EyupBEY/Glass/README.md

# The Most Quality ESP32-S3 Board Ever Made
