EyupBEY/Glass/List of Receipts.xlsx

Price(TL) | Amount | Name | Value | Link | Subtotal: | 2194.02
37.06 | 1 | J1 | GSB1C41110SSHR | https://www.e-komponent.com/usb-type-c-2-0-receptacle-connector-gsb1c41110sshr
36.27 | 1 | J2 | TB002-500-02BE | https://www.e-komponent.com/2-position-wire-to-board-terminal-block-horizontal-with-board-22350
50.49 | 1 | J5 | 5051102491 | https://www.e-komponent.com/fpc-connector
31.83 | 1 | ANT1 | SR4W035 | https://www.e-komponent.com/24-ghz-wi-fi-bluetooth-anten-serica-smd
27.45 | 1 | U1 | USBLC6-2SC6 | USBLC6-2SC6 UMW - TVS Diyotlar - e-komponent (https://www.e-komponent.com/17v-clamp-5a-8-20s-ipp-tvs-diode-surface-mount-sot-23-34240)
74.4 | 1 | U2 + U3 + Q2 | TP4056 Module | https://robolinkmarket.com/tp4056-type-c-korumali-sarj-modulu
40.68 | 1 | U4 | LDL1117S33R | https://www.e-komponent.com/linear-voltage-regulator-ic-33v-1-output-12a-sot-223
235.41 | 1 | U5 | ESP32-S3R8 | https://tr.aliexpress.com/item/1005003691510275.html
91.18 | 1 | U7 | W25Q128JVSIQ | https://tr.aliexpress.com/item/1005005997333641.html?gatewayAdapt=glo2tur
136.78 | 1 | U8 | RT9193-12GB | https://tr.aliexpress.com/item/1005006177716976.html
7.28 | 1 | U9 | RT9193-28GB | https://tr.aliexpress.com/item/1005006177716976.html
394.85 | 1 | U6 | LY68L6400 | https://tr.aliexpress.com/i/1005003978604678.html
27.72 | 2 | RESET, PROGRAM | 434121043816 | https://www.e-komponent.com/tactile-switch-434121043816
25.49 | 1 | SW1 | 1825232-1 | https://www.e-komponent.com/slide-switch-spdt-through-hole-right-angle-19828
124.5 | 1 | K1 (MicroSD Card Holder) | 112J-TDAR-R01 | https://www.e-komponent.com/micro-sdsocket-push-push-type
13.72 | 1 | Q1 | AO3421E | https://www.e-komponent.com/p-channel-30v-3a-ta-14w-ta-surface-mount-sot-23-3
211.88 | 1 | D1, D2 | PMEG6030EVPX | https://tr.aliexpress.com/item/1005004051915626.html
21.08 | 1 | Y1 | ECS-400-10-37B2-CKM-TR | https://www.e-komponent.com/40-mhz-10ppm-crystal
47.44 | 1 | Y2 | ECS-.327-6-34QCS-TR | https://www.e-komponent.com/crystal-6pf-24024
4.9 | 3 | L1, L3 | LQG15HN2N0C02D | https://www.e-komponent.com/2-nh-unshielded-multilayer-inductor
7.35 | 2 | L2 | LQW18AN24NG00D | https://www.e-komponent.com/24-nh-unshielded-wirewound-inductor-23755
2.35 | 10 | R1, R2, R18, R19 | 5.1K(0603) | https://www.e-komponent.com/chip-resistor-pulse-withstanding-thick-film-14642
0.64 | 50 | R14, R20, R21, R22, R23, R25, R26, R29, R27, R28 | 10K(0603) | https://www.e-komponent.com/chip-resistor-moisture-resistant-thick-film-17999
13.72 | 2 | R3 | TC33X-2-103E | https://www.e-komponent.com/j-lead-surface-mount-trimmer-potentiometer-cermet
0.74 | 10 | R4, R15, R16 | 100K(0603) | https://www.e-komponent.com/chip-resistor-thick-film-17297
0.74 | 10 | R5 | 1K(0603) | https://www.e-komponent.com/chip-resistor-thick-film-14993
1.03 | 10 | R6 | 100(0603) | https://www.e-komponent.com/chip-resistor-moisture-resistant-thick-film-17993
0.75 | 25 | R7, R9, R10, R11, R12, R13, R17, R24 | 0(0603) | https://www.e-komponent.com/chip-resistor-moisture-resistant-thick-film-14334
0.93 | 10 | R8 | 499(0603) | https://www.e-komponent.com/chip-resistor-moisture-resistant-thick-film-12583
4.7 | 5 | C3, C31 | 10μF (Electrolytic) | https://www.e-komponent.com/aluminum-electrolytic-capacitors-24491
9.07 | 10 | C11 | 10μF | https://www.e-komponent.com/ceramic-capacitors-14163
1.72 | 50 | C5, C7, C10, C19, C21, C22, C24, C25 | 1μF | https://www.e-komponent.com/1-uf-ceramic-capacitor-cl21b105kafnnng
2.01 | 50 | C1, C2, C6, C8, C9, C12, C13, C26, C27, C30, C32 | 0.1μF | https://www.e-komponent.com/ceramic-capacitors-15476
1.52 | 10 | C20, C23 | 22nF | https://www.e-komponent.com/ceramic-capacitors-16412
4.9 | 3 | C4 | 0.01μF --> 0.012μF | https://www.e-komponent.com/ceramic-capacitors-21433
1.64 | 10 | C14, C15, C16, C17 | 16pF | https://www.e-komponent.com/ceramic-capacitor-31485
1.83 | 10 | C18 | 1.5pF | https://www.e-komponent.com/15-pf-ceramic-capacitor-gjm1555c1h1r5cb01d
0 | 1 | J3, J4, J6, J7, J8 | Standard Connectors
 |  | İsimlendirme sıralamasını şöyle yap: R11 ile R23 arası 10uF dir diye.
 |  | Bazı parçaları fazlaca yazdım ki yedek de olsun, bazıları tam gereken kadar onları arttır.
