EyupBEY/Glass/Schematic.pdf

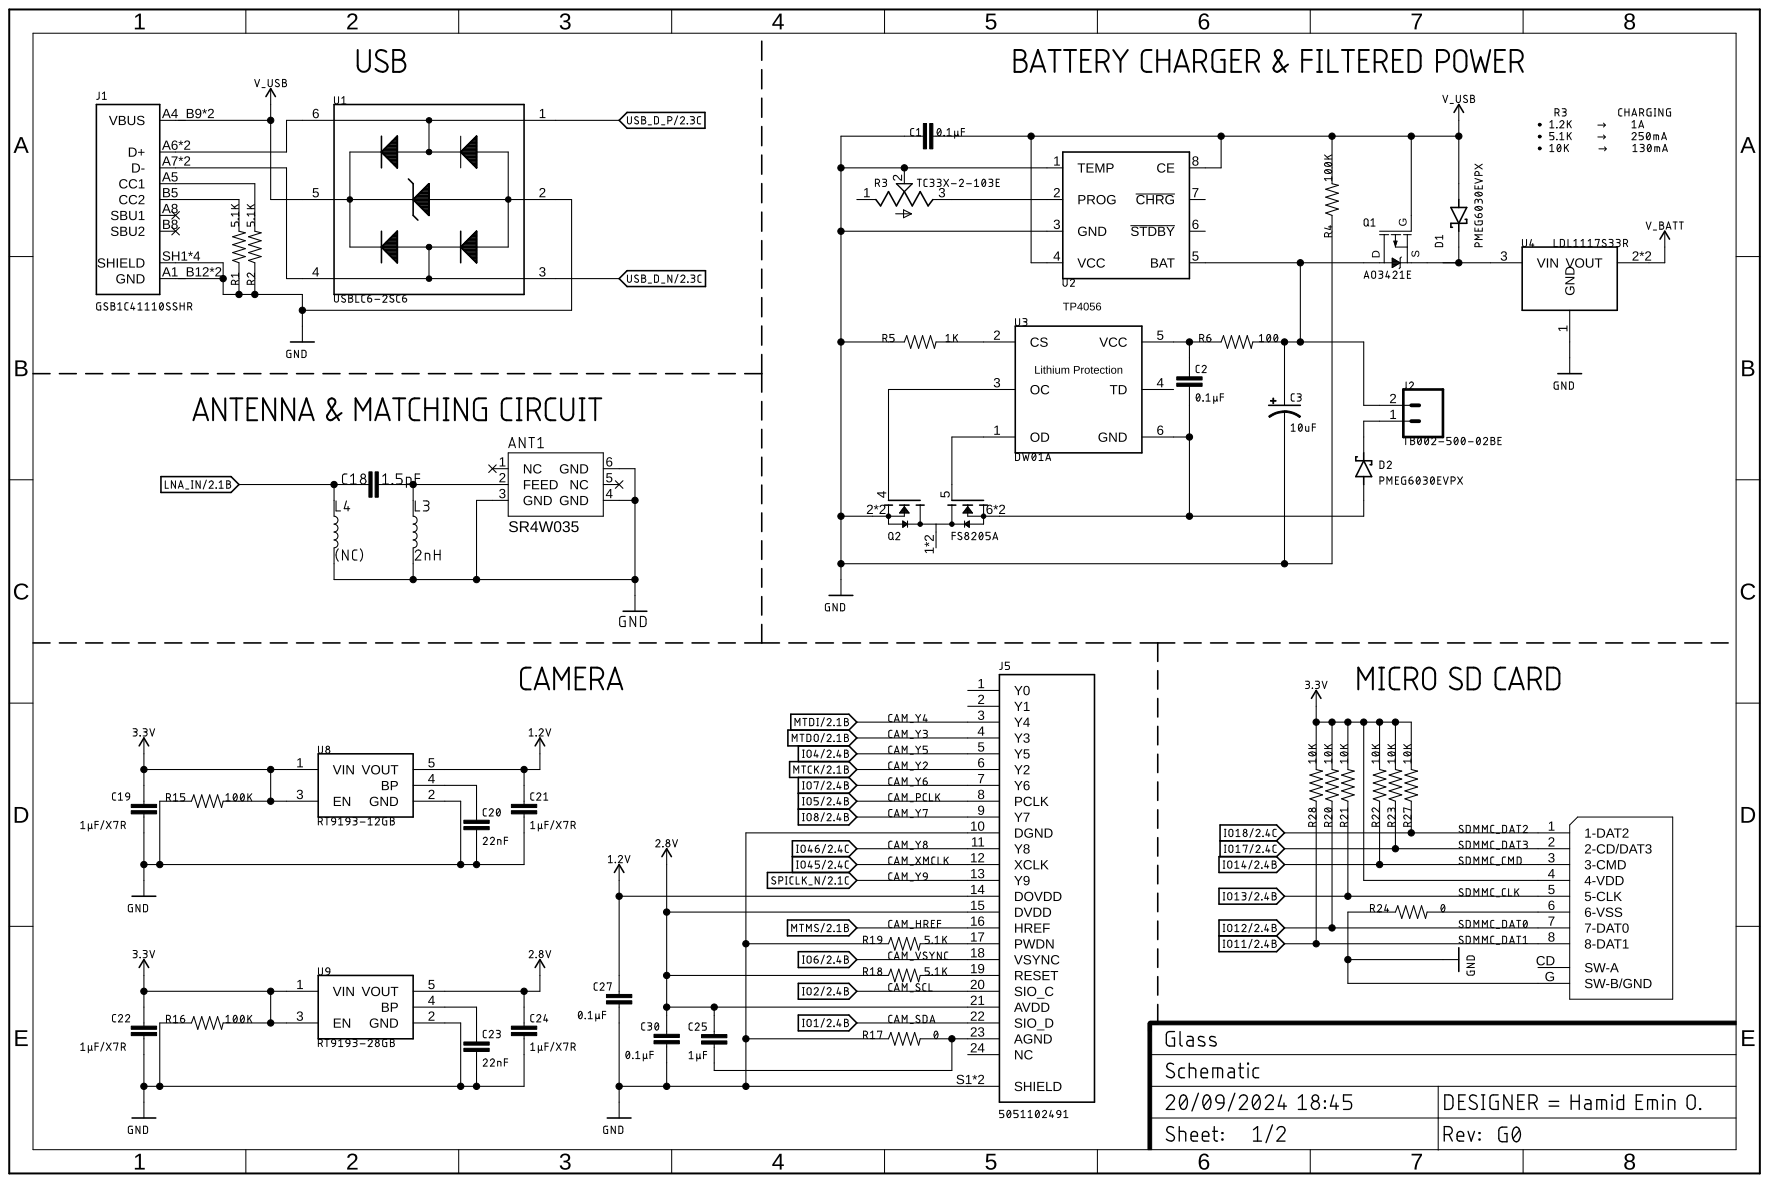
[picture p24: page 1]

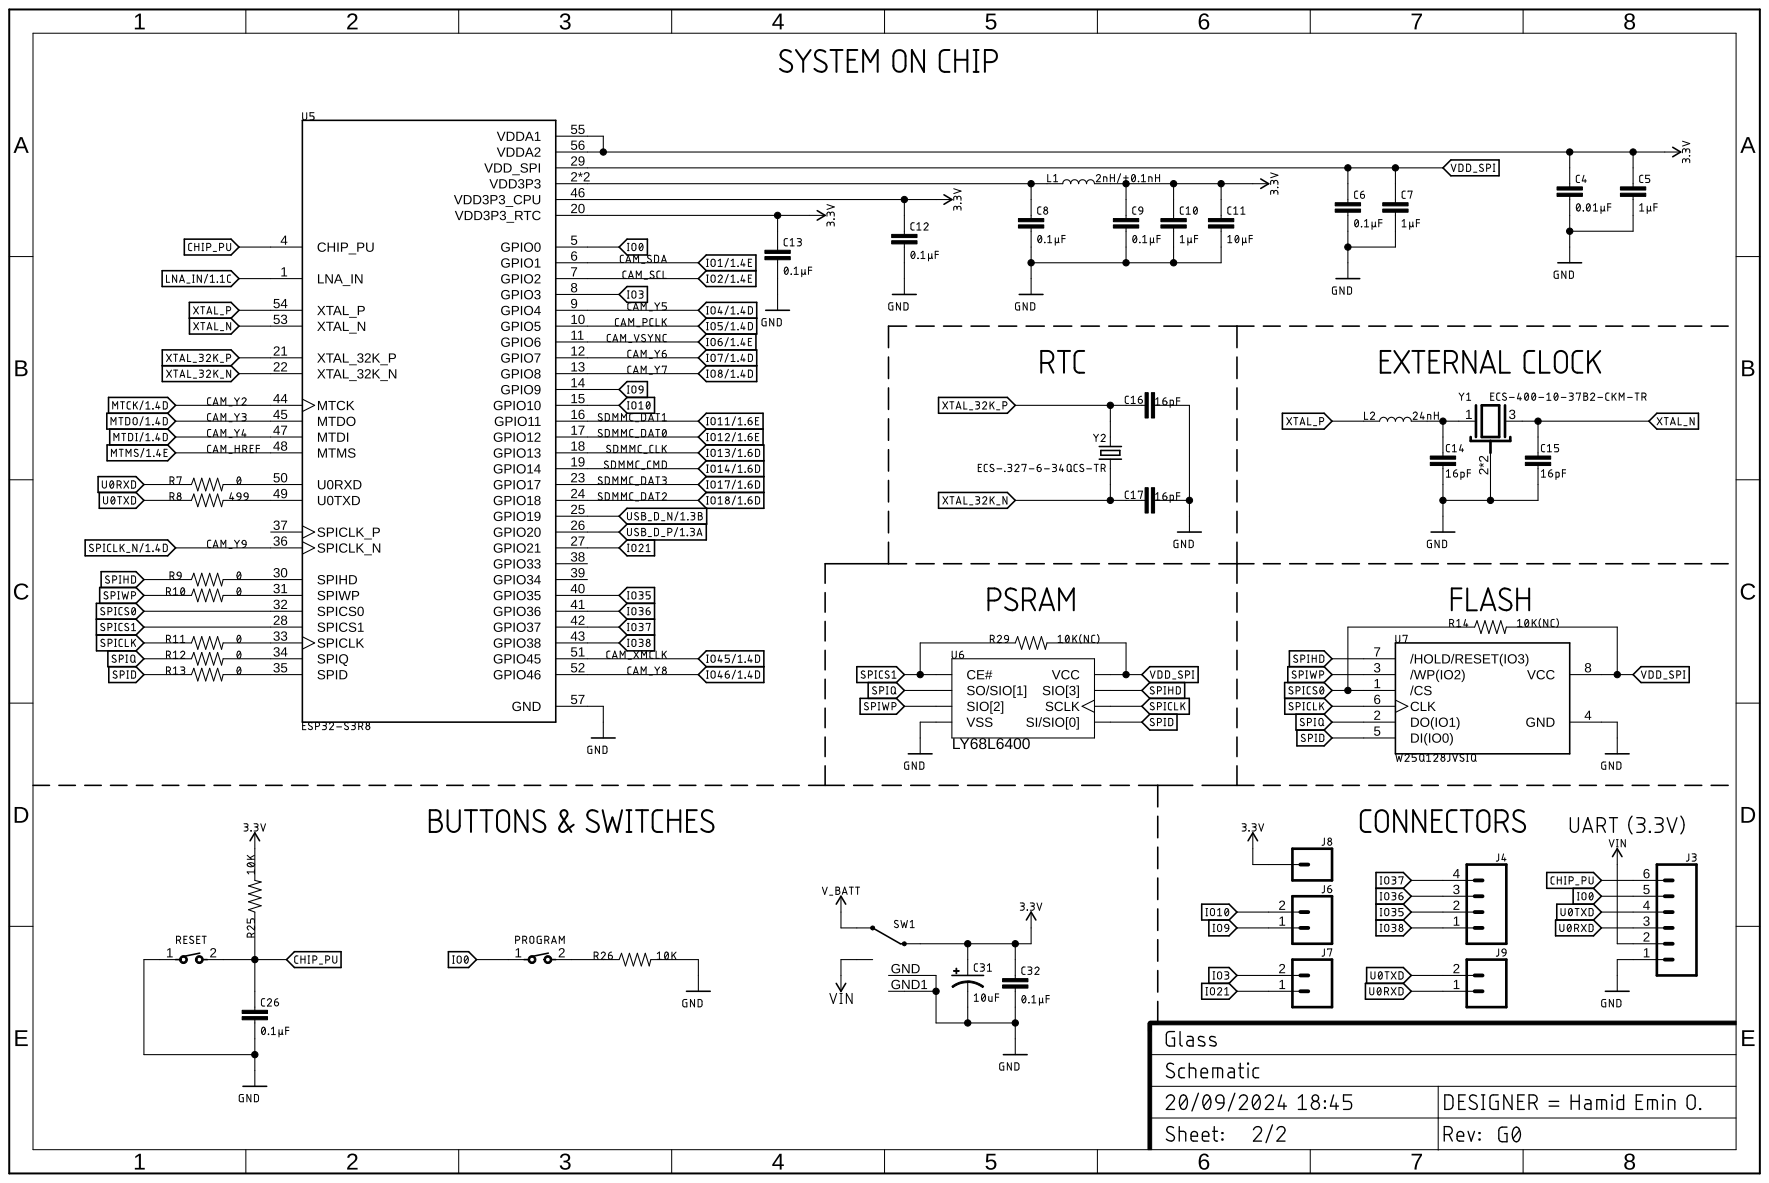
[picture p25: page 2]
