EyupBEY/Glass/Schematic.brd

## EAGLE design Schematic.brd (2024-09-20)

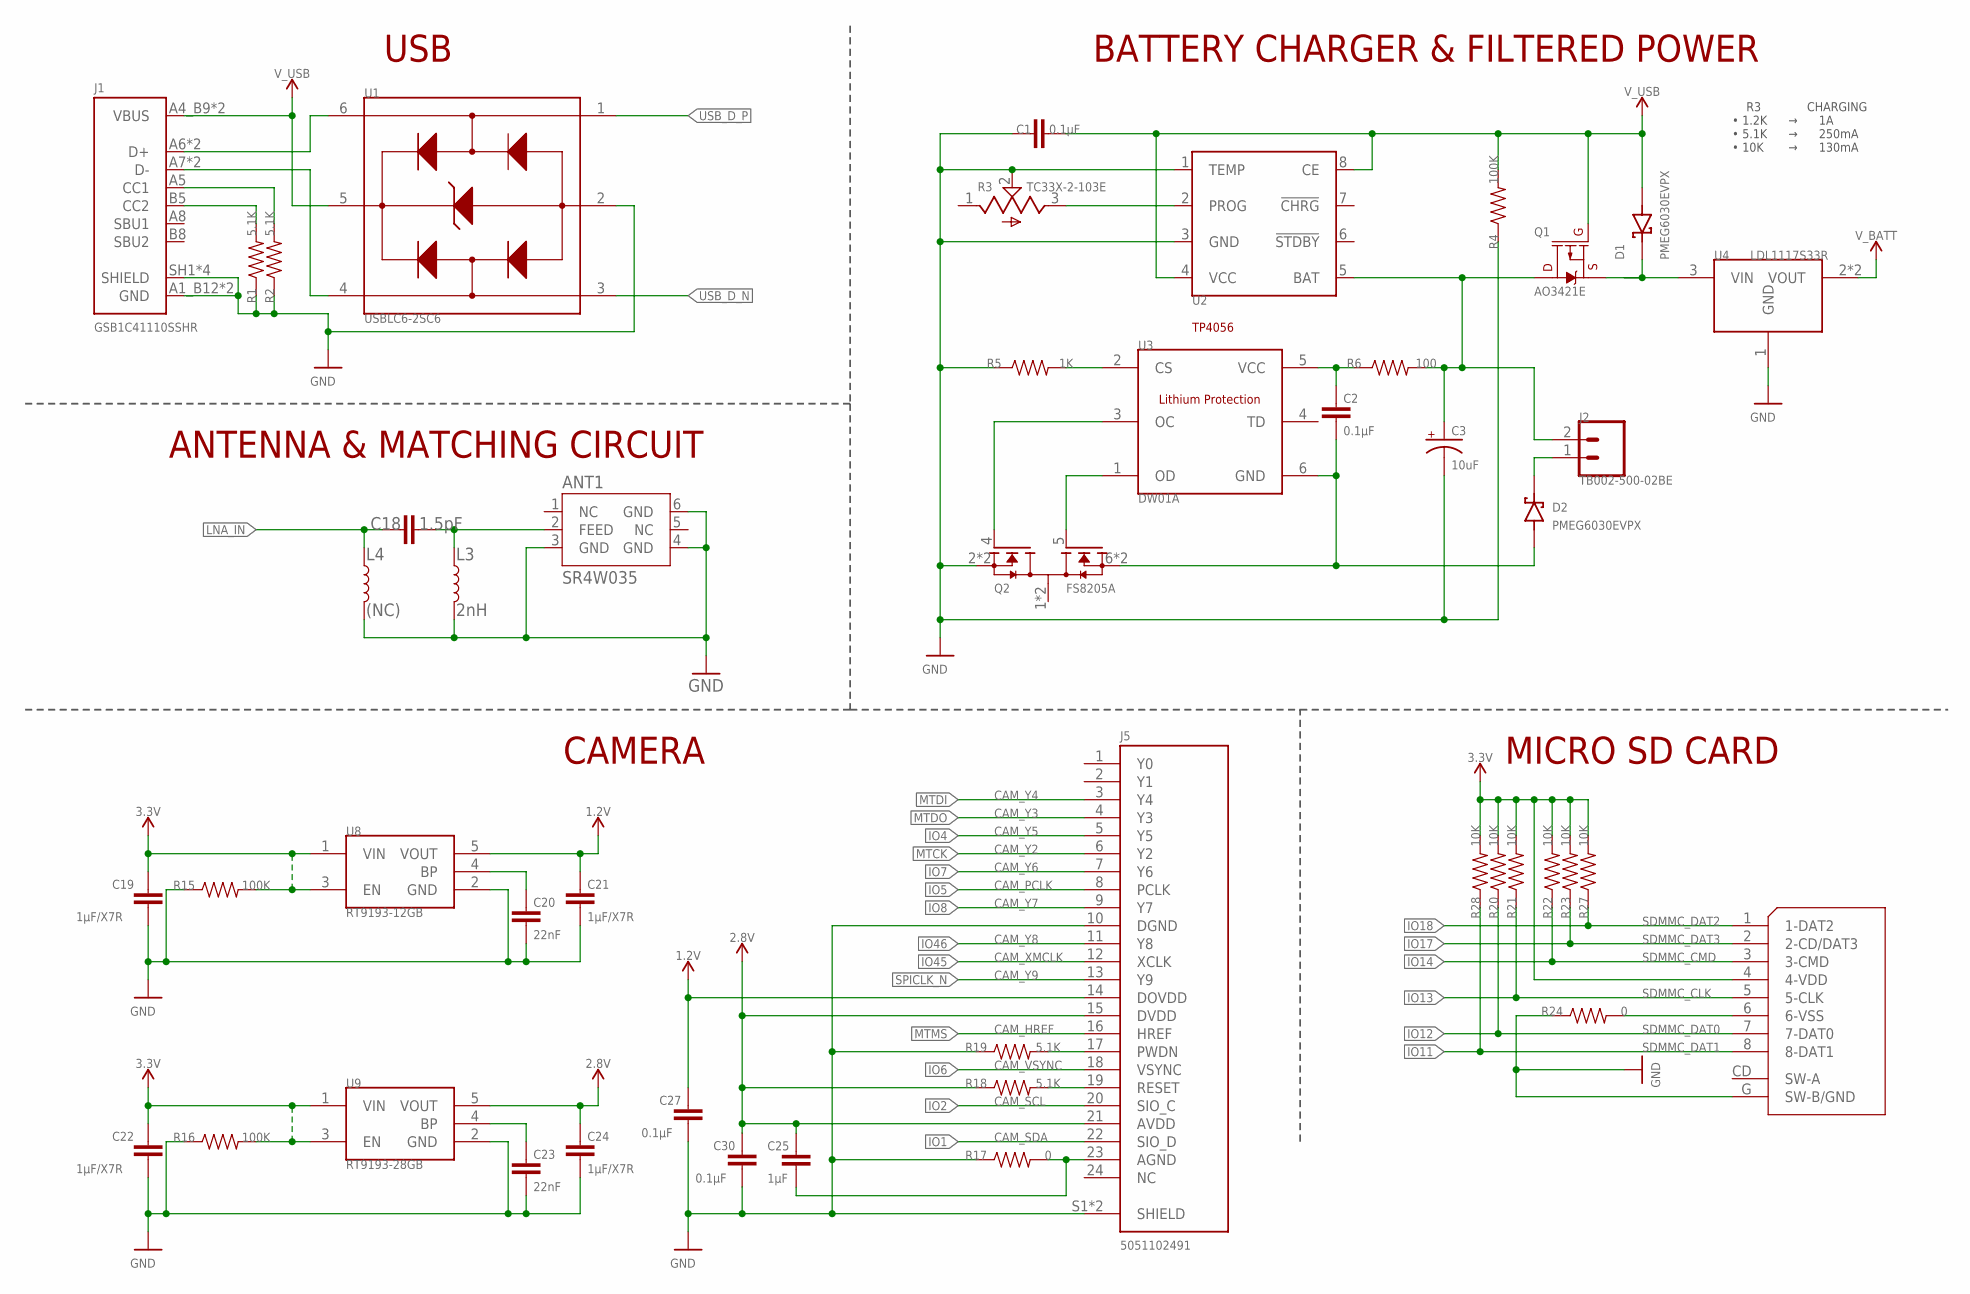
[picture p26: schematic Schematic.sch, sheet 1]

Parts:
ANT1: SR4W035
C1, C2, C27, C30: 0.1μF; 0805
C3: 10uF; CPOL-RADIAL-2.5MM-5MM
C18: 1.5pF; 0402
C19, C21, C22, C24: 1μF/X7R; 0805
C20, C23: 22nF; 0603
C25: 1μF; 0805
D1, D2: PMEG6030EVPX; DIO_PMEG6030EVPX
J1: GSB1C41110SSHR; AMPHENOL_GSB1C41110SSHR
J2: TB002-500-02BE; SCREWTERMINAL-5MM-2
J5: 5051102491; MOLEX_5051102491
K1: 112J-TDAR-R01
L3: 2nH; 0402
L4: (NC); 0402
Q1: AO3421E; SOT23-3
Q2: FS8205A; SOP65P640X120-8N
R1, R2, R18, R19: 5.1K; 0603
R3: TC33X-2-103E; TRIM_TC33X-2-103E
R4, R15, R16: 100K; 0603
R5: 1K; 0603
R6: 100; 0603
R17, R24: 0; 0603
R20, R21, R22, R23, R27, R28: 10K; 0603
U1: USBLC6-2SC6; SOT95P280X145-6N
U2: TP4056; SOT23-8
U3: DW01A; SOT23-6
U4: LDL1117S33R; SOT230P700X180-4N
U8: RT9193-12GB; SOT94P279X129-5N
U9: RT9193-28GB; SOT94P279X129-5N

Connections:
1.1V: C21.2, C27.2, J5.14 (DOVDD), U8.5 (VOUT)
2.8V: C24.2, C25.2, C30.2, J5.15 (DVDD), J5.21 (AVDD), R18.1, U9.5 (VOUT)
3.3V: C19.2, C22.2, K1.4 (4-VDD), R15.2, R16.2, R20.2, R21.2, R22.2, R23.2, R27.2, R28.2, U8.1 (VIN), U8.3 (EN), U9.1 (VIN), U9.3 (EN); also elsewhere on the board
GND: ANT1.3 (GND), ANT1.4 (GND), ANT1.6 (GND), C1.1, C3.2 (-), C19.1, C20.1, C21.1, C22.1, C23.1, C24.1, C27.1, C30.1, J1.A1_B12 (GND), J1.B1_A12 (GND), J1.SH1 (SHIELD), J1.SH2 (SHIELD), J1.SH3 (SHIELD), J1.SH4 (SHIELD), J5.10 (DGND), J5.S1 (SHIELD), J5.S2 (SHIELD), K1.G (SW-B/GND), L3.2, L4.2, Q2.2 (S1), Q2.3 (S1), R1.1, R2.1, R3.2 (W), R4.1, R5.1, R15.1, R16.1, R17.1, R19.1, R24.1, U1.2 (GND), U2.1 (TEMP), U2.3 (GND), U4.1 (GND), U8.2 (GND), U9.2 (GND); also elsewhere on the board
IO1: J5.22 (SIO_D); also elsewhere on the board
IO2: J5.20 (SIO_C); also elsewhere on the board
IO4: J5.5 (Y5); also elsewhere on the board
IO5: J5.8 (PCLK); also elsewhere on the board
IO6: J5.18 (VSYNC); also elsewhere on the board
IO7: J5.7 (Y6); also elsewhere on the board
IO8: J5.9 (Y7); also elsewhere on the board
IO11: K1.8 (8-DAT1), R28.1; also elsewhere on the board
IO12: K1.7 (7-DAT0), R20.1; also elsewhere on the board
IO13: K1.5 (5-CLK), R21.1; also elsewhere on the board
IO14: K1.3 (3-CMD), R22.1; also elsewhere on the board
IO17: K1.2 (2-CD/DAT3), R23.1; also elsewhere on the board
IO18: K1.1 (1-DAT2), R27.1; also elsewhere on the board
IO45: J5.12 (XCLK); also elsewhere on the board
IO46: J5.11 (Y8); also elsewhere on the board
LNA_IN: C18.1, L4.1; also elsewhere on the board
MTCK: J5.6 (Y2); also elsewhere on the board
MTDI: J5.3 (Y4); also elsewhere on the board
MTDO: J5.4 (Y3); also elsewhere on the board
MTMS: J5.16 (HREF); also elsewhere on the board
unnamed: J1.A7 (D-), J1.B7 (D-), U1.4 (I/O2_OUT)
unnamed: Q2.5 (G2), U3.1 (OD)
unnamed: Q2.4 (G1), U3.3 (OC)
unnamed: J1.A5 (CC1), R2.2
unnamed: R5.2, U3.2 (CS)
unnamed: J1.B5 (CC2), R1.2
unnamed: K1.6 (6-VSS), R24.2
unnamed: R3.3 (CW), U2.2 (PROG)
unnamed: D2.1 (K), J2.1
unnamed: C2.2, R6.1, U3.5 (VCC)
unnamed: ANT1.2 (FEED), C18.2, L3.1
unnamed: J1.A6 (D+), J1.B6 (D+), U1.6 (I/O1_OUT)
unnamed: C2.1, D2.2 (A), Q2.6 (S2), Q2.7 (S2), U3.6 (GND)
unnamed: C20.2, U8.4 (BP)
unnamed: C23.2, U9.4 (BP)
unnamed: J5.19 (RESET), R18.2
unnamed: C3.1 (+), J2.2, Q1.3 (D), R6.2, U2.5 (BAT)
unnamed: D1.1 (K), Q1.2 (S), U4.3 (VIN)
unnamed: J5.17 (PWDN), R19.2
unnamed: C25.1, J5.23 (AGND), R17.2
SPICLK_N: J5.13 (Y9); also elsewhere on the board
USB_D_N: U1.3 (I/O2_IN); also elsewhere on the board
USB_D_P: U1.1 (I/O1_IN); also elsewhere on the board
V_BATT: U4.2 (VOUT), U4.4 (VOUT); also elsewhere on the board
V_USB: C1.2, D1.2 (A), J1.A4_B9 (VBUS), J1.B4_A9 (VBUS), Q1.1 (G), R4.2, U1.5 (VBUS), U2.4 (VCC), U2.8 (CE)

Notes on the sheet:
R3 CHARGING • 1.2K → 1A • 5.1K → 250mA • 10K → 130mA
USB
BATTERY CHARGER & FILTERED POWER
ANTENNA & MATCHING CIRCUIT
MICRO SD CARD
CAMERA
CAM_Y2
CAM_Y3
CAM_Y4
CAM_HREF
CAM_Y9
CAM_Y8
CAM_XMCLK
CAM_Y7
CAM_Y6
CAM_VSYNC
CAM_PCLK
CAM_Y5
CAM_SCL
CAM_SDA

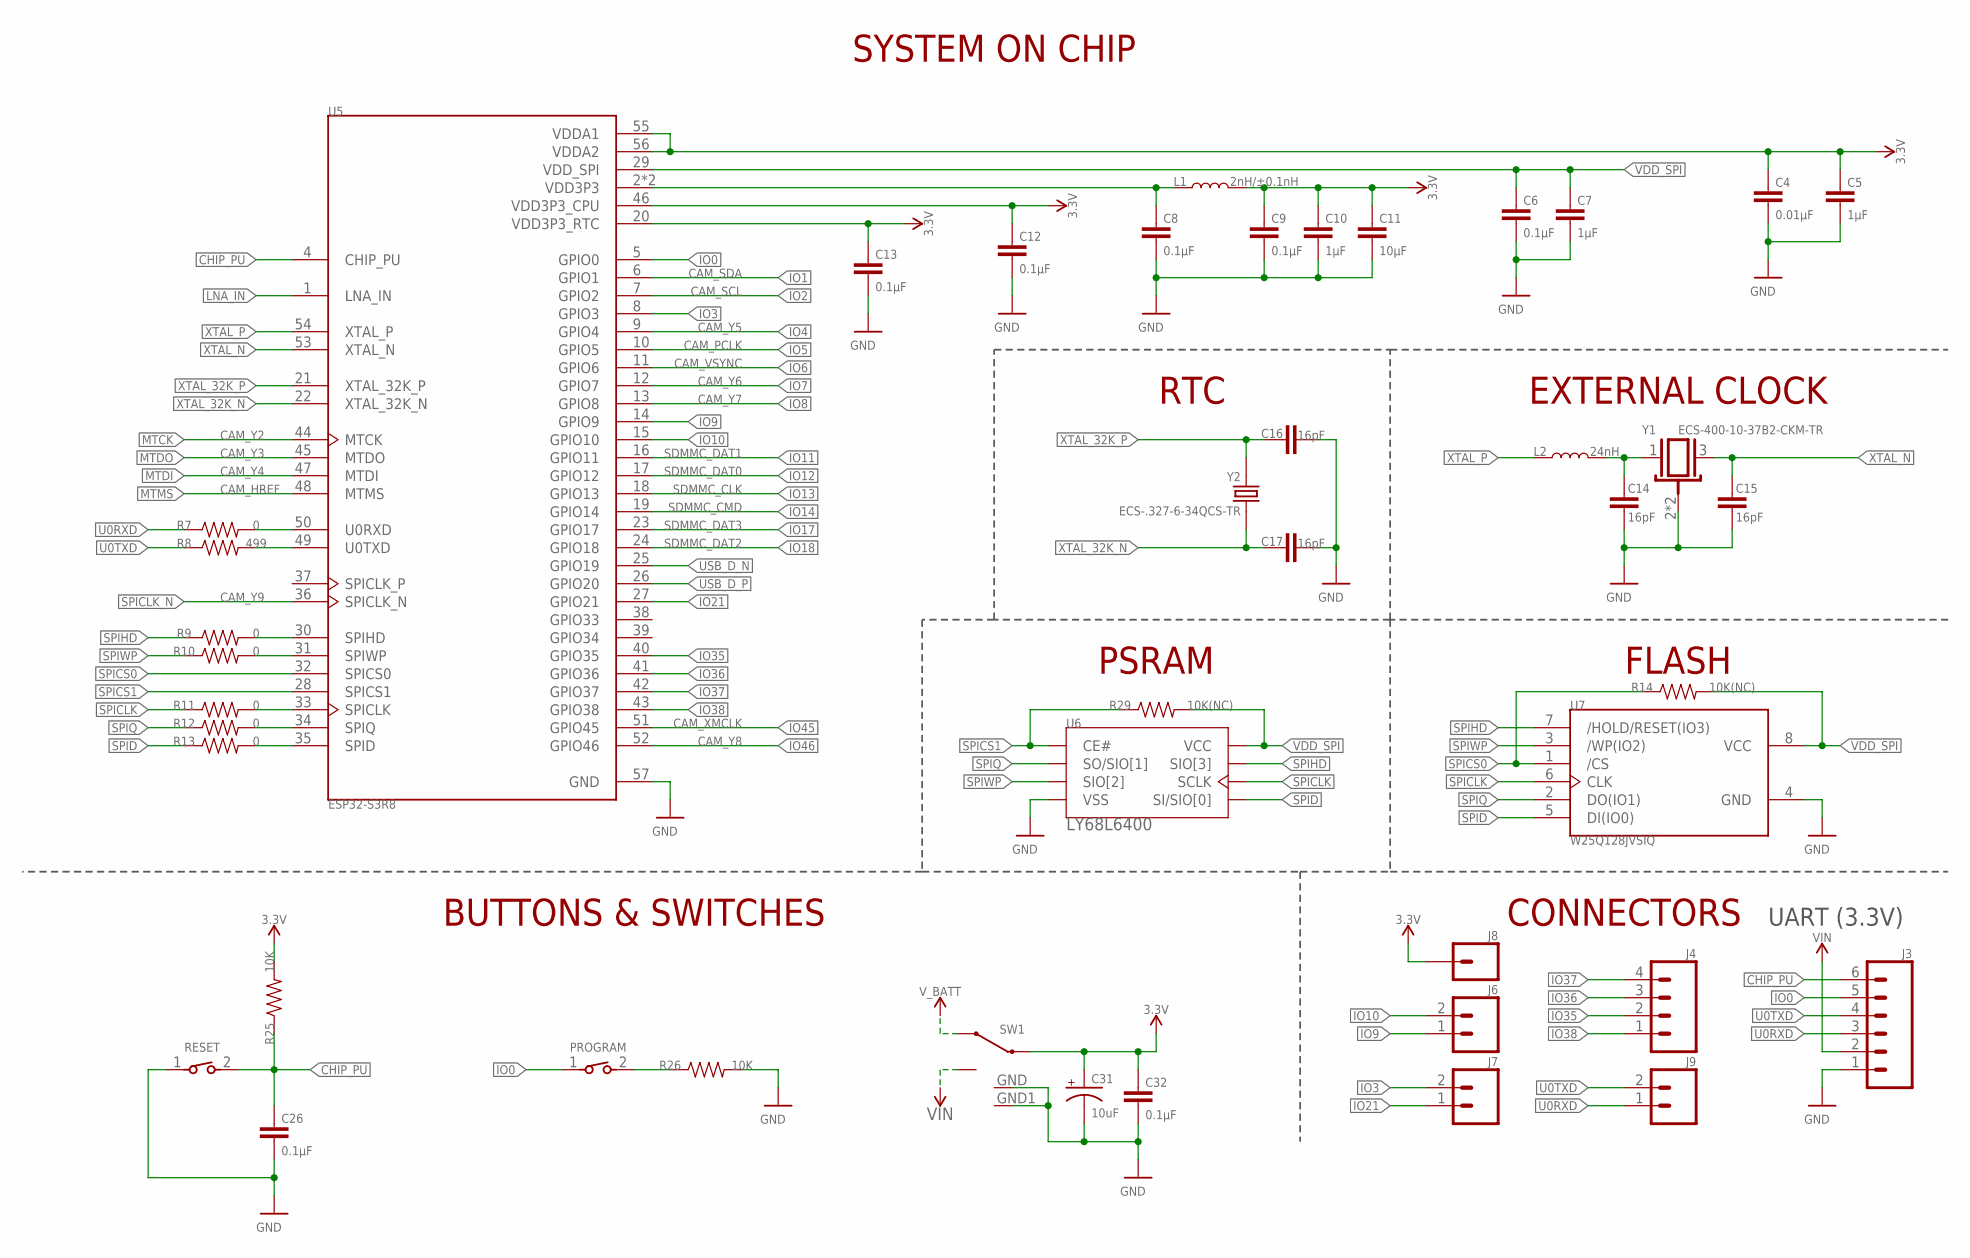
[picture p27: schematic Schematic.sch, sheet 2]

Parts:
C4: 0.01μF; 0603
C5, C7, C10: 1μF; 0805
C6, C8, C9, C12, C13, C26, C32: 0.1μF; 0805
C11: 10μF; 0805
C14, C15, C16, C17: 16pF; 0402
C31: 10uF; CPOL-RADIAL-2.5MM-5MM
J3: CONN_06SILK_FEMALE_PTH; 1X06
J4: CONN_04PTH; 1X04
J6, J7, J9: CONN_02; 1X02
J8: CONN_01; 1X01
L1: 2nH/±0.1nH; 0402
L2: 24nH; 0603
PROGRAM: 434121043816
R7, R9, R10, R11, R12, R13: 0; 0603
R8: 499; 0603
R14, R29: 10K(NC); 0603
R25, R26: 10K; 0603
RESET: 434121043816
SW1: 1825232-1
U5: ESP32-S3R8; IC_ESP32-S3
U6: LY68L6400; SOP
U7: W25Q128JVSIQ; SOIC127P790X216-8N
Y1: ECS-400-10-37B2-CKM-TR; XTAL_ECS-400-10-37B2-CKM-TR
Y2: ECS-.327-6-34QCS-TR; XTAL_ECS-.327-6-34QCS-TR

Connections:
3.3V: C4.2, C5.2, C9.2, C10.2, C11.2, C12.2, C13.2, C31.1 (+), C32.2, J8.1, L1.2, R25.2, SW1.2, U5.20 (VDD3P3_RTC), U5.46 (VDD3P3_CPU), U5.55 (VDDA1), U5.56 (VDDA2); also elsewhere on the board
CHIP_PU: C26.2, J3.6, R25.1, RESET.2, U5.4 (CHIP_PU)
GND: C4.1, C5.1, C6.1, C7.1, C8.1, C9.1, C10.1, C11.1, C12.1, C13.1, C14.1, C15.1, C16.2, C17.2, C26.1, C31.2 (-), C32.1, J3.1, R26.2, RESET.1, SW1.GND, SW1.GND1, U5.57 (GND), U6.VSS, U7.4 (GND), Y1.2 (GND), Y1.4 (GND); also elsewhere on the board
IO0: J3.5, PROGRAM.1, U5.5 (GPIO0)
IO1: U5.6 (GPIO1); also elsewhere on the board
IO2: U5.7 (GPIO2); also elsewhere on the board
IO3: J7.2, U5.8 (GPIO3)
IO4: U5.9 (GPIO4); also elsewhere on the board
IO5: U5.10 (GPIO5); also elsewhere on the board
IO6: U5.11 (GPIO6); also elsewhere on the board
IO7: U5.12 (GPIO7); also elsewhere on the board
IO8: U5.13 (GPIO8); also elsewhere on the board
IO9: J6.1, U5.14 (GPIO9)
IO10: J6.2, U5.15 (GPIO10)
IO11: U5.16 (GPIO11); also elsewhere on the board
IO12: U5.17 (GPIO12); also elsewhere on the board
IO13: U5.18 (GPIO13); also elsewhere on the board
IO14: U5.19 (GPIO14); also elsewhere on the board
IO17: U5.23 (GPIO17); also elsewhere on the board
IO18: U5.24 (GPIO18); also elsewhere on the board
IO21: J7.1, U5.27 (GPIO21)
IO35: J4.2, U5.40 (GPIO35)
IO36: J4.3, U5.41 (GPIO36)
IO37: J4.4, U5.42 (GPIO37)
IO38: J4.1, U5.43 (GPIO38)
IO45: U5.51 (GPIO45); also elsewhere on the board
IO46: U5.52 (GPIO46); also elsewhere on the board
LNA_IN: U5.1 (LNA_IN); also elsewhere on the board
MTCK: U5.44 (MTCK); also elsewhere on the board
MTDI: U5.47 (MTDI); also elsewhere on the board
MTDO: U5.45 (MTDO); also elsewhere on the board
MTMS: U5.48 (MTMS); also elsewhere on the board
unnamed: C8.2, L1.1, U5.2 (VDD3P3), U5.3 (VDD3P3)
unnamed: C14.2, L2.2, Y1.1
unnamed: PROGRAM.2, R26.1
unnamed: R7.2, U5.50 (U0RXD)
unnamed: R8.2, U5.49 (U0TXD)
unnamed: R9.2, U5.30 (SPIHD)
unnamed: R10.2, U5.31 (SPIWP)
unnamed: R11.2, U5.33 (SPICLK)
unnamed: R12.2, U5.34 (SPIQ)
unnamed: R13.2, U5.35 (SPID)
SPICLK: R11.1, U6.SCLK, U7.6 (CLK)
SPICLK_N: U5.36 (SPICLK_N); also elsewhere on the board
SPICS0: R14.1, U5.32 (SPICS0), U7.1 (/CS)
SPICS1: R29.1, U5.28 (SPICS1), U6.CE#
SPID: R13.1, U6.SI/SIO[0], U7.5 (DI(IO0))
SPIHD: R9.1, U6.SIO[3], U7.7 (/HOLD/RESET(IO3))
SPIQ: R12.1, U6.SO/SIO[1], U7.2 (DO(IO1))
SPIWP: R10.1, U6.SIO[2], U7.3 (/WP(IO2))
U0RXD: J3.3, J9.1, R7.1
U0TXD: J3.4, J9.2, R8.1
USB_D_N: U5.25 (GPIO19); also elsewhere on the board
USB_D_P: U5.26 (GPIO20); also elsewhere on the board
VDD_SPI: C6.2, C7.2, R14.2, R29.2, U5.29 (VDD_SPI), U6.VCC, U7.8 (VCC)
VIN: J3.2, SW1.1
V_BATT: SW1.3; also elsewhere on the board
XTAL_32K_N: C17.1, U5.22 (XTAL_32K_N), Y2.1 (I/O)
XTAL_32K_P: C16.1, U5.21 (XTAL_32K_P), Y2.2 (O/I)
XTAL_N: C15.2, U5.53 (XTAL_N), Y1.3
XTAL_P: L2.1, U5.54 (XTAL_P)

Notes on the sheet:
SYSTEM ON CHIP
EXTERNAL CLOCK
RTC
FLASH
BUTTONS & SWITCHES
CONNECTORS
UART (3.3V)
PSRAM

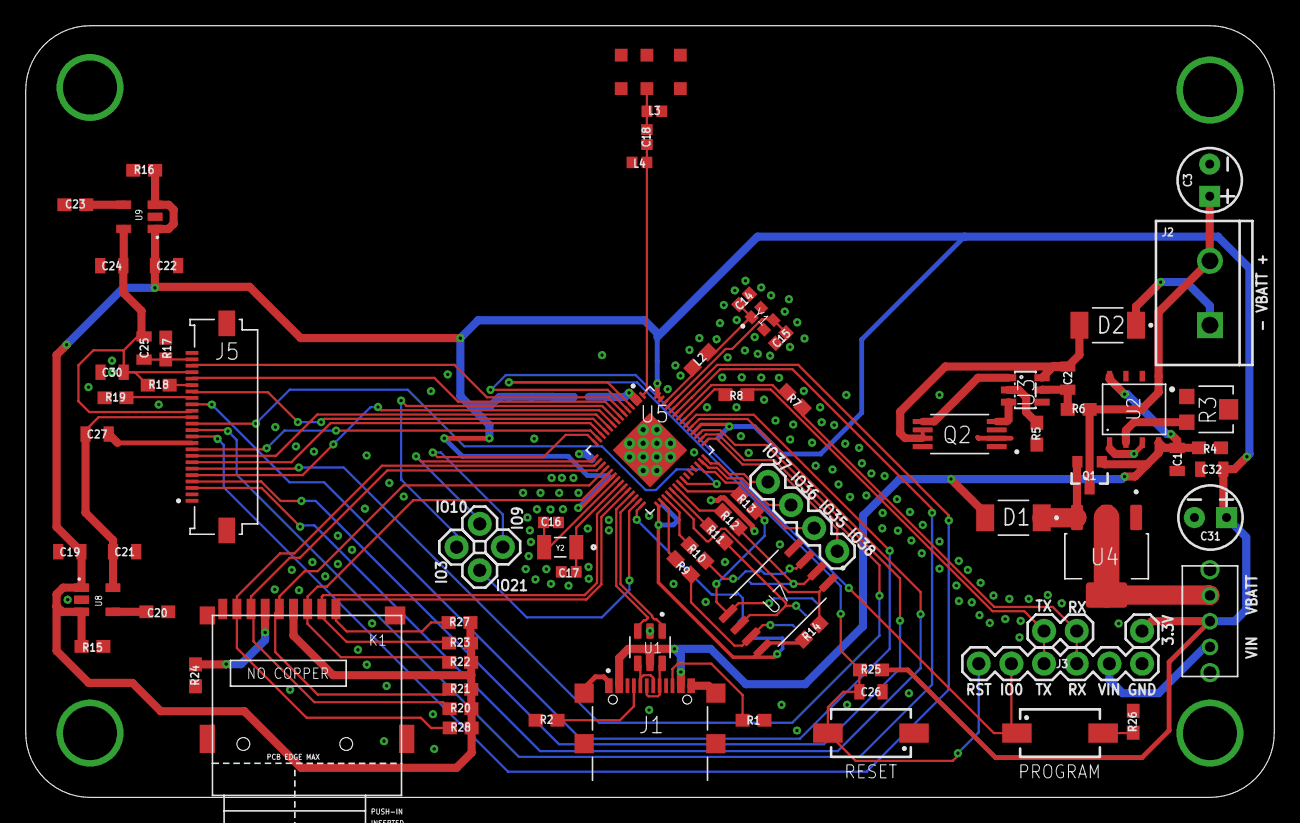
[picture p28: board Schematic.brd from above]

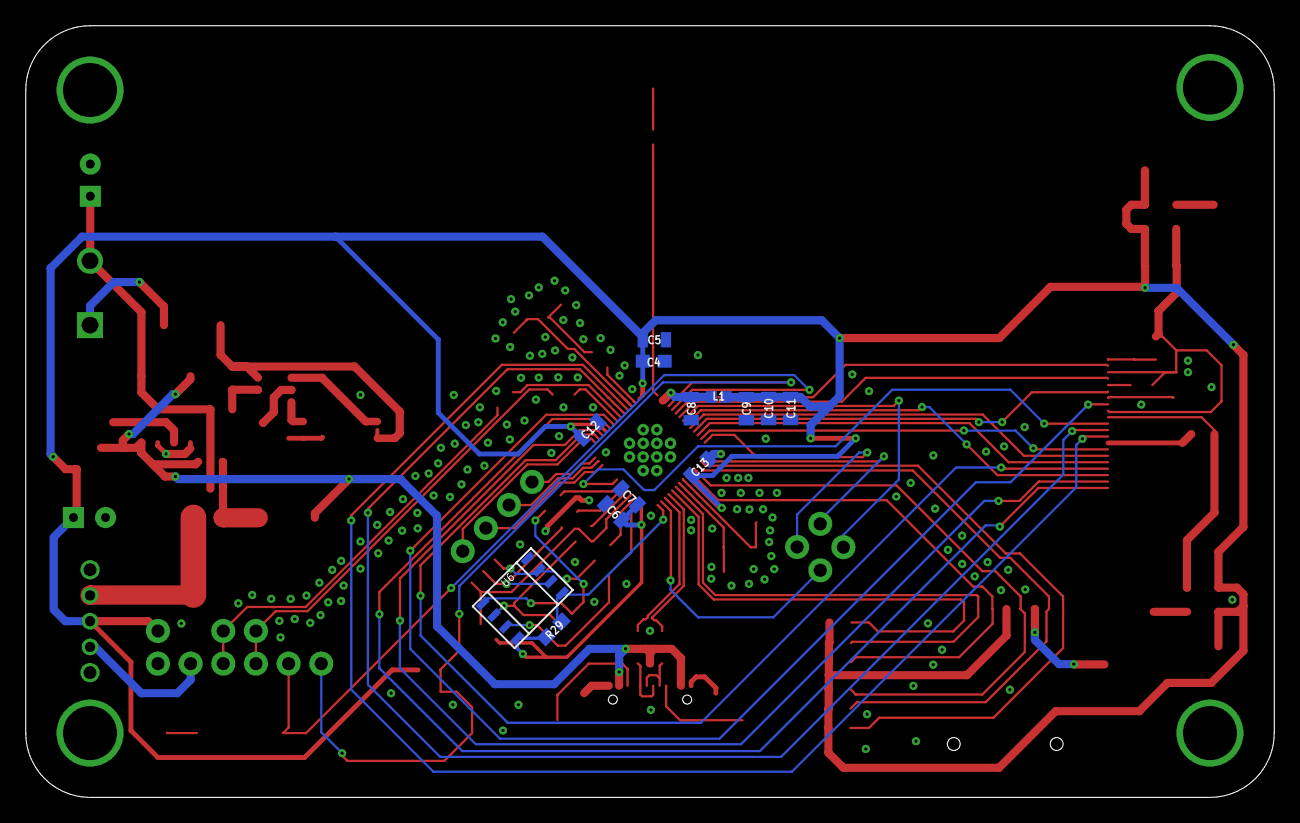
[picture p29: board Schematic.brd from below]

Board: 2 copper layers, 97.1 x 60.0 mm, 92 parts (13 on the bottom side), 84 nets.
